ZhuochengHU/UCR/EE175_FILES/Hardware design/Remote-control/remote-control.pdf

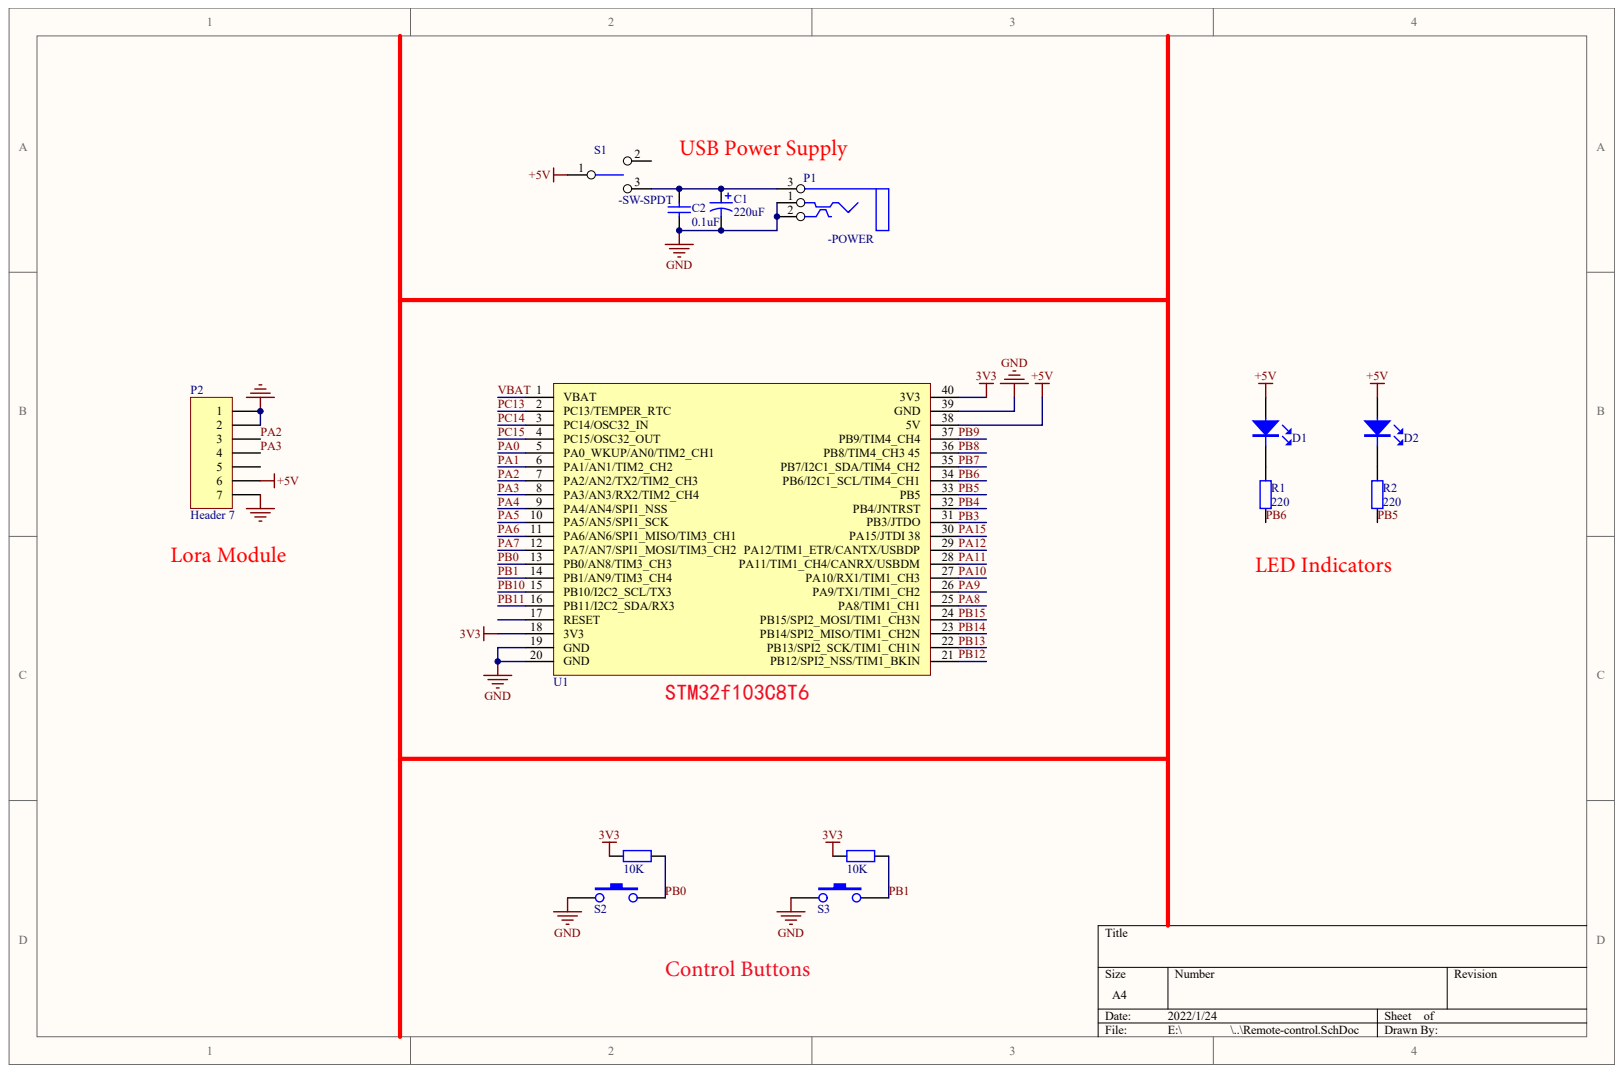
[picture p10: page 1]

GND 19 | PB13
GND 20 | PB12

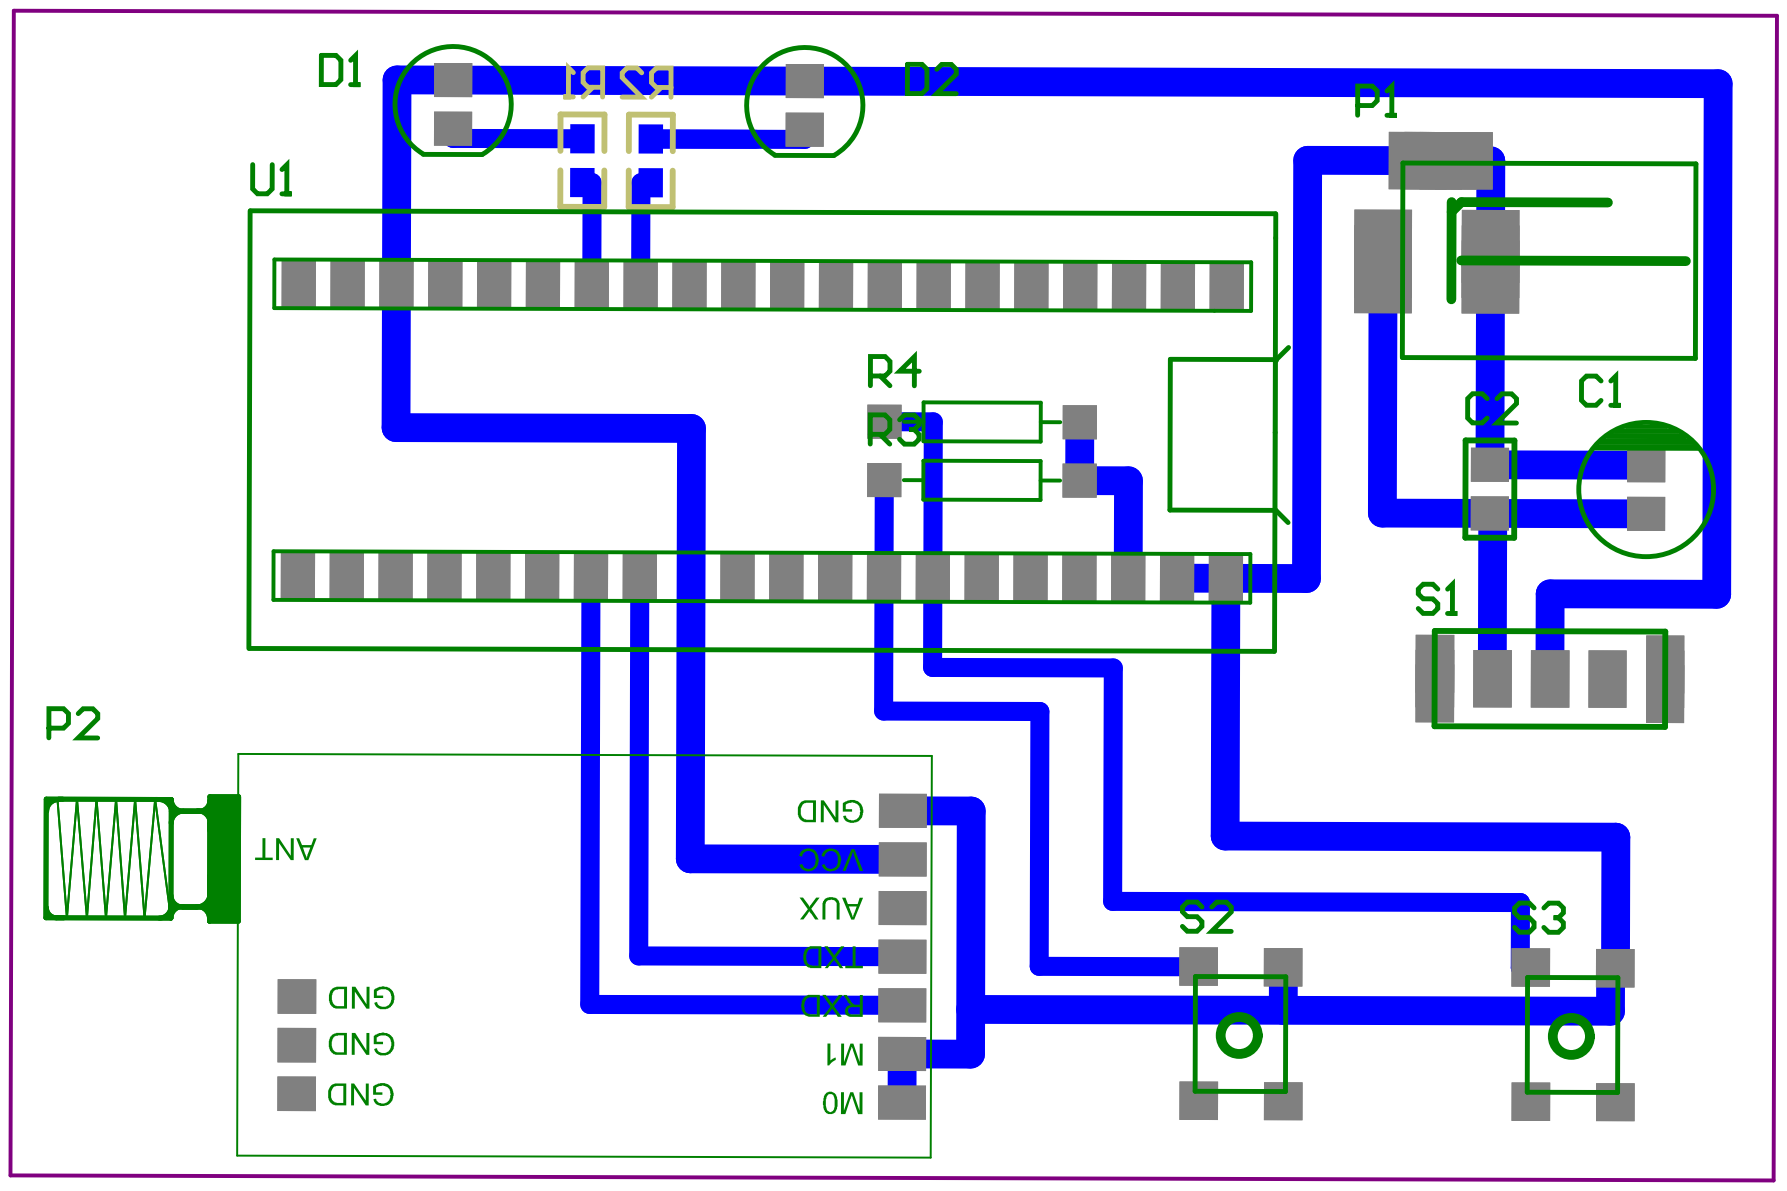
[picture p11: page 2]
