ZhuochengHU/UCR/EE175_FILES/Hardware design/Socket-board/Socket-board.pdf

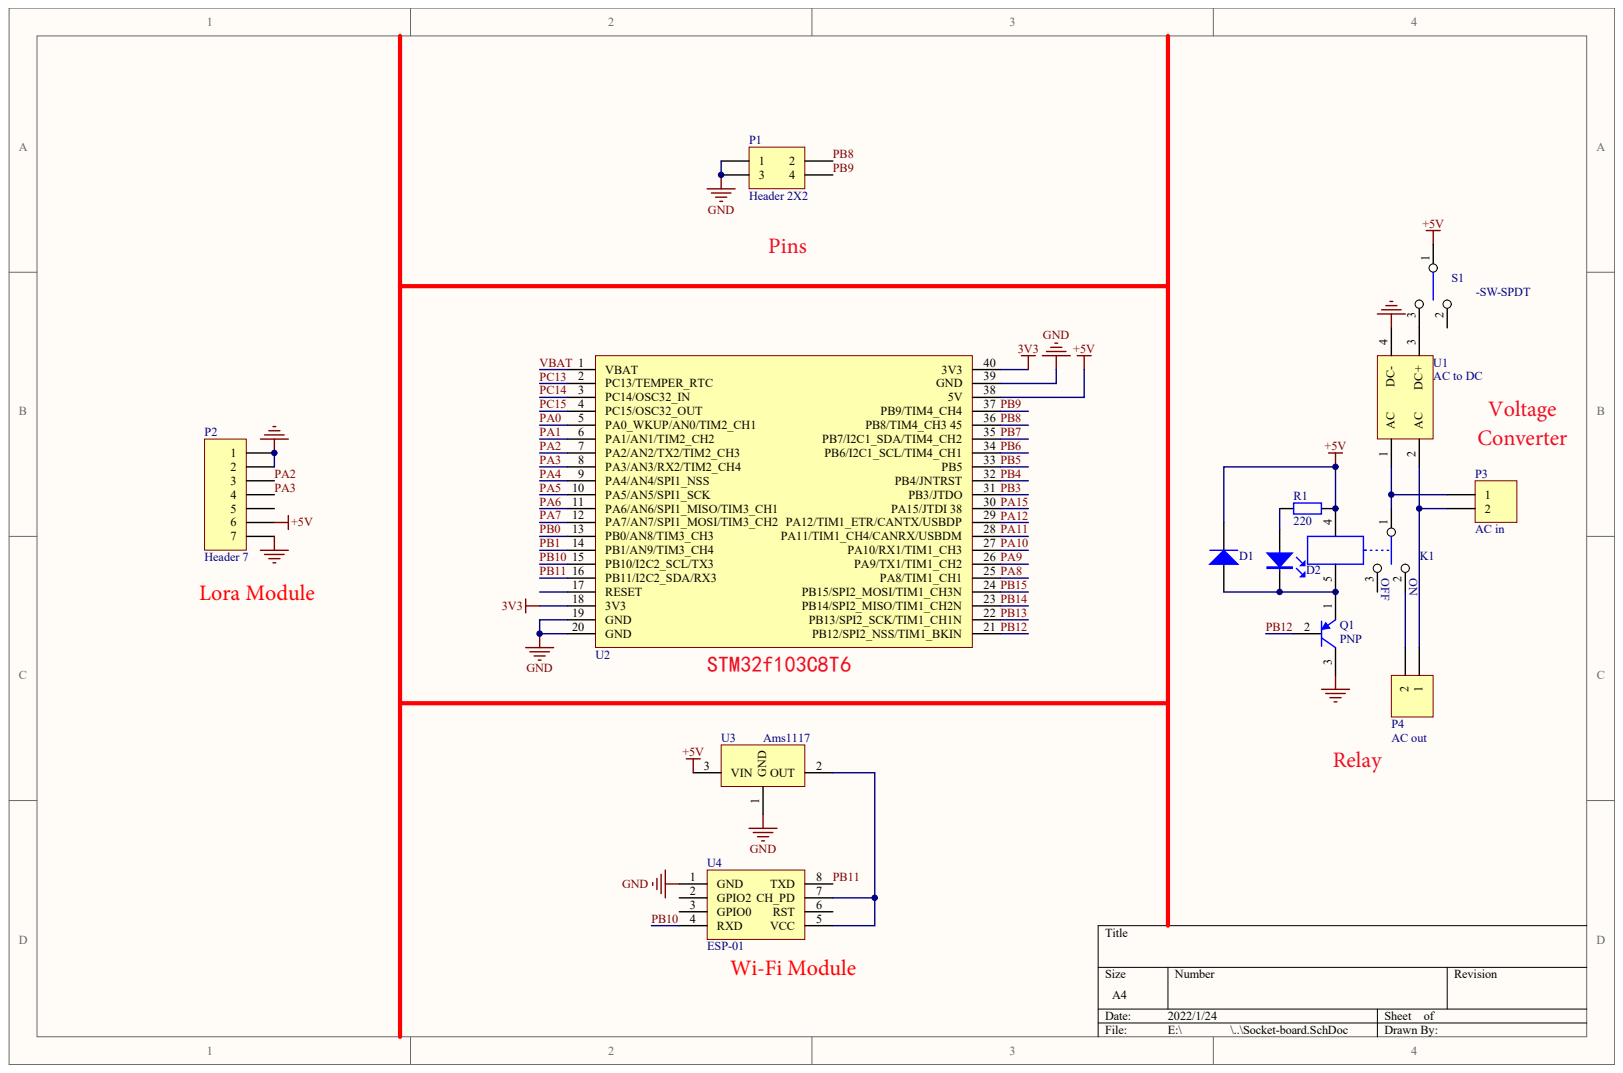
[picture p12: page 1]

GND 19 | PB13
GND 20 | PB12

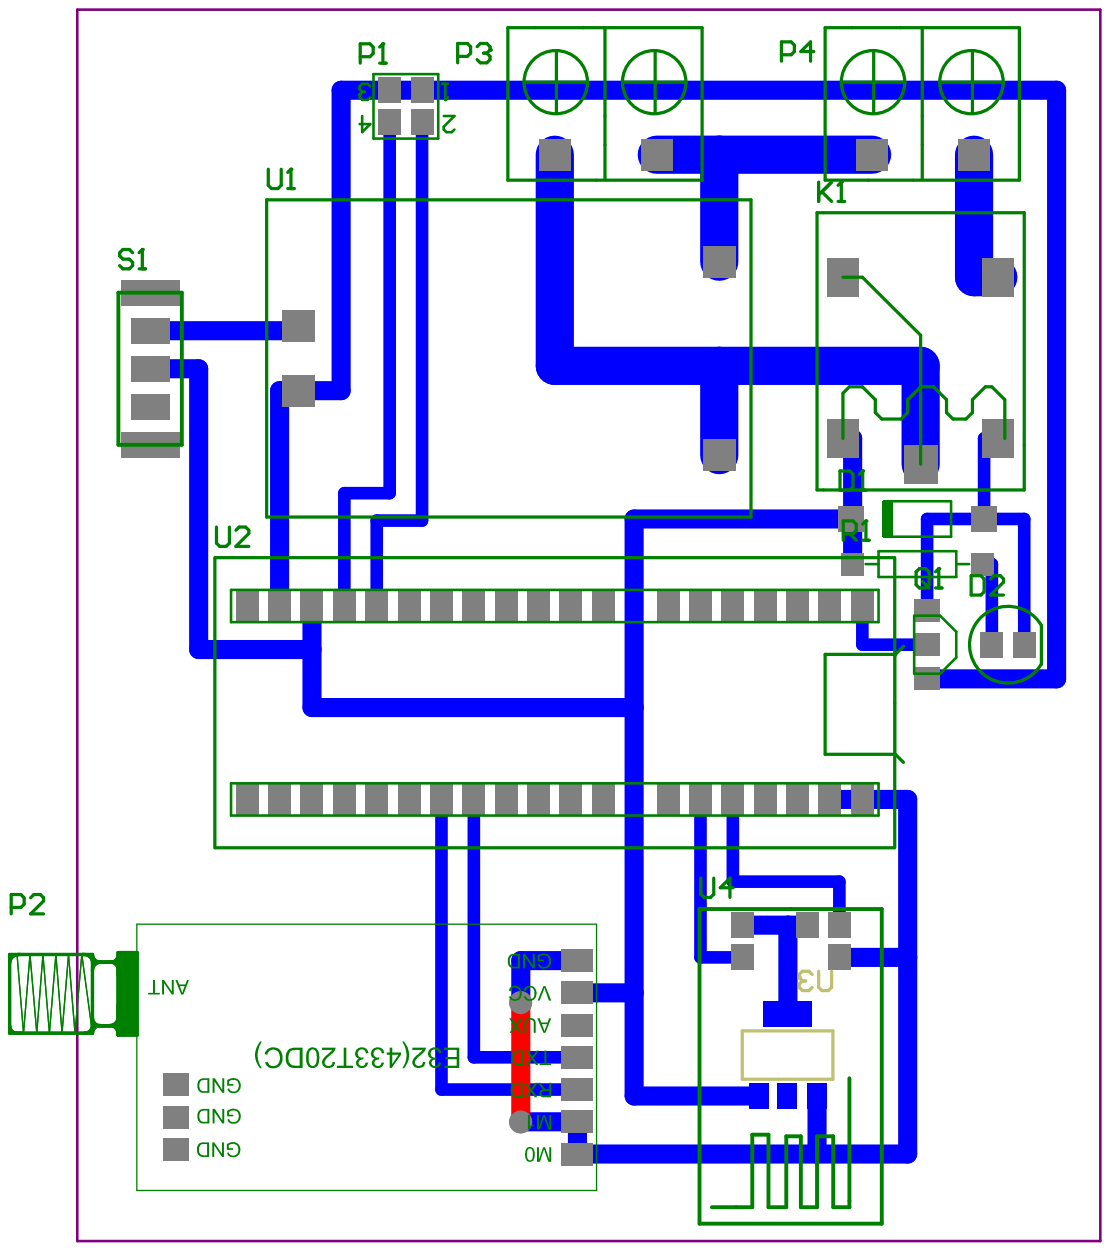
[picture p13: page 2]
