ZhuochengHU/UCR/(list of files, drawings)

Other design files:
EE175_FILES/Hardware design/Remote-control/Remote-control.PcbDoc
EE175_FILES/Hardware design/Remote-control/Remote-control.PrjPcb
EE175_FILES/Hardware design/Remote-control/Remote-control.SchDoc
EE175_FILES/Hardware design/Socket-board/Socket-board.PcbDoc
EE175_FILES/Hardware design/Socket-board/Socket-board.PrjPcb
EE175_FILES/Hardware design/Socket-board/Socket-board.SchDoc
