ZhuochengHU/UCR/EE 120B/Lab 3/turnin/zhu026_lab3_part3.c

/*	Author: zhu026
 *  Partner(s) Name: Jo Smith
 *	Lab Section:
 *	Assignment:
 *	Exercise Description: [optional - include for your own benefit]
 *
 *	I acknowledge all content contained herein, excluding template or example
 *	code, is my own original work.
 */
#include <avr/io.h>
#ifdef _SIMULATE_
#include "simAVRHeader.h"
#endif

int main(void) {
    /* Insert DDR and PORT initializations */
    /* Insert your solution below */
    DDRA = 0x00; PORTA = 0xFF;
    DDRC = 0xFF; PORTC = 0x00;
    unsigned char tempA = 0x00;
    unsigned char tempC = 0x00;

    while (1) {
	tempA = PINA;
	tempC = 0x00;
	if (((tempA & 0x0D) == 0x0D) || ((tempA & 0x0E) == 0x0E) || ((tempA & 0x0F) == 0x0F)) {
                tempC = 0x3F;
        }
	else if (((tempA & 0x0A) == 0x0A) || ((tempA & 0x0B) == 0x0B) || ((tempA & 0x0C) == 0x0C)) {
                tempC = 0x3E;
        }
	else if (((tempA & 0x07) == 0x07) || ((tempA & 0x08) == 0x08) || ((tempA & 0x09) == 0x09)) {
                tempC = 0x3C;
        }
	else if (((tempA & 0x05) == 0x05) || ((tempA & 0x06) == 0x06)) {
                tempC = 0x38;
        }
	else if (((tempA & 0x03) == 0x03) || ((tempA & 0x04) == 0x04)) {
                tempC = 0x70;
        }
	else if (((tempA & 0x01) == 0x01) || ((tempA & 0x02) == 0x02)) {
		tempC = 0x60;
	}
	else {
		tempC = 0x40;
	}
	
	if (((tempA & 0x30) == 0x30) && (tempA & 0x40) != 0x40) {
		tempC = tempC | 0x80;
	}
	
	
	PORTC = tempC;
	
    }
    return 0;
}
