ZhuochengHU/UCR/EE175_FILES/Embedded system/Remote-control/SYSTEM/usart/usart.c

#include "sys.h"
#include "usart.h"	  

unsigned char Uart1_Receive_Data;
unsigned char Uart1_Receive_Change=0;

/*
  功能描述: 发送一个字节
  函数参数: byte —— 要发送的字节
  返回说明: 无
*/
void UART_SendByte(unsigned char byte)	
{
	USART_SendData(USART1,byte);//向串口1发送数据
	while(USART_GetFlagStatus(USART1,USART_FLAG_TC)!=SET);//等待发送结束
}

/*
  功能描述: 串口发送字符串
  函数参数: s —— 指向字符串的指针(字符串以'\0'结尾)
  返回说明: 无
  注：如果在字符串结尾有'\n'，则会发送一个回车换行      
*/
void UART_SendStr(unsigned char *s)
{
	while( *s != '\0')
	{
		UART_SendByte( *s );	
		s ++;
	}
}
 
void uart_init(u32 bound)
{
    //GPIO端口设置
    GPIO_InitTypeDef GPIO_InitStructure;
	USART_InitTypeDef USART_InitStructure;
	NVIC_InitTypeDef NVIC_InitStructure;
	 
	RCC_APB2PeriphClockCmd(RCC_APB2Periph_USART1|RCC_APB2Periph_GPIOA, ENABLE);	//使能USART1，GPIOA时钟
     //USART1_TX   PA.9
    GPIO_InitStructure.GPIO_Pin = GPIO_Pin_9; //PA.9
    GPIO_InitStructure.GPIO_Speed = GPIO_Speed_50MHz;
    GPIO_InitStructure.GPIO_Mode = GPIO_Mode_AF_PP;	//复用推挽输出
    GPIO_Init(GPIOA, &GPIO_InitStructure);
   
    //USART1_RX	  PA.10
    GPIO_InitStructure.GPIO_Pin = GPIO_Pin_10;
    GPIO_InitStructure.GPIO_Mode = GPIO_Mode_IPU;//上拉输入
    GPIO_Init(GPIOA, &GPIO_InitStructure);  

   //Usart1 NVIC 配置

    NVIC_InitStructure.NVIC_IRQChannel = USART1_IRQn;
	NVIC_InitStructure.NVIC_IRQChannelPreemptionPriority=3 ;//抢占优先级3
	NVIC_InitStructure.NVIC_IRQChannelSubPriority = 3;		//子优先级3
	NVIC_InitStructure.NVIC_IRQChannelCmd = ENABLE;			//IRQ通道使能
	NVIC_Init(&NVIC_InitStructure);	//根据指定的参数初始化VIC寄存器
  
   //USART 初始化设置

	USART_InitStructure.USART_BaudRate = bound;//一般设置为9600;
	USART_InitStructure.USART_WordLength = USART_WordLength_8b;//字长为8位数据格式
	USART_InitStructure.USART_StopBits = USART_StopBits_1;//一个停止位
	USART_InitStructure.USART_Parity = USART_Parity_No;//无奇偶校验位
	USART_InitStructure.USART_HardwareFlowControl = USART_HardwareFlowControl_None;//无硬件数据流控制
	USART_InitStructure.USART_Mode = USART_Mode_Rx | USART_Mode_Tx;	//收发模式

    USART_Init(USART1, &USART_InitStructure); //初始化串口
    USART_ITConfig(USART1, USART_IT_RXNE, ENABLE);//开启中断
    USART_Cmd(USART1, ENABLE);                    //使能串口 
		UART_SendByte(0xff);

}


void USART1_IRQHandler(void)                	//串口1中断服务程序
{
	u8 Res;
	if(USART_GetITStatus(USART1, USART_IT_RXNE) != RESET)  //接收中断
	{
		Res =USART_ReceiveData(USART1);//(USART1->DR);	//读取接收到的数据		 
		Uart1_Receive_Data=Res;
		Uart1_Receive_Change=1;
	} 
} 	
