ZhuochengHU/UCR/EE175_FILES/Embedded system/Remote-control/MyCode/UART2.c

#include "UART2.h"

unsigned char Uart2_Receive_Data;
unsigned char Uart2_Receive_Change=0;




/*
  功能描述: 发送一个字节
  函数参数: byte —— 要发送的字节
  返回说明: 无
*/
void UART2_SendByte(unsigned char byte)	
{
	USART_SendData(USART2,byte);//向串口1发送数据
	while(USART_GetFlagStatus(USART2,USART_FLAG_TC)!=SET);//等待发送结束
}

/*
  功能描述: 串口发送字符串
  函数参数: s —— 指向字符串的指针(字符串以'\0'结尾)
  返回说明: 无
  注：如果在字符串结尾有'\n'，则会发送一个回车换行      
*/
void UART2_SendStr(unsigned char *s)
{
	while( *s != '\0')
	{
		UART2_SendByte( *s );	
		s ++;
	}
}

//初始化IO 串口2
//pclk1:PCLK1时钟频率(Mhz)
//bound:波特率	  
void Uart2_Init(u32 bound)
{  
  GPIO_InitTypeDef GPIO_InitStructure;
  USART_InitTypeDef USART_InitStructure;
 	NVIC_InitTypeDef NVIC_InitStructure;
 
	RCC_APB2PeriphClockCmd(RCC_APB2Periph_GPIOA, ENABLE);//使能GPIOA时钟
	RCC_APB1PeriphClockCmd(RCC_APB1Periph_USART2,ENABLE);//使能USART2时钟
	

	GPIO_InitStructure.GPIO_Pin = GPIO_Pin_2;	//PA2
	GPIO_InitStructure.GPIO_Speed = GPIO_Speed_50MHz;
  GPIO_InitStructure.GPIO_Mode = GPIO_Mode_AF_PP;	//复用推挽
  GPIO_Init(GPIOA, &GPIO_InitStructure);
   
  GPIO_InitStructure.GPIO_Pin = GPIO_Pin_3;//PA3
  GPIO_InitStructure.GPIO_Mode = GPIO_Mode_IPU;//上拉输入
  GPIO_Init(GPIOA, &GPIO_InitStructure);  

	RCC_APB1PeriphResetCmd(RCC_APB1Periph_USART2,ENABLE);//复位串口2
	RCC_APB1PeriphResetCmd(RCC_APB1Periph_USART2,DISABLE);//停止复位
 
	
	USART_InitStructure.USART_BaudRate = bound;//一般设置为9600;
	USART_InitStructure.USART_WordLength = USART_WordLength_8b;//8位数据长度
	USART_InitStructure.USART_StopBits = USART_StopBits_1;//一个停止位
	USART_InitStructure.USART_Parity = USART_Parity_No;///奇偶校验位
	USART_InitStructure.USART_HardwareFlowControl = USART_HardwareFlowControl_None;//无硬件数据流控制
	USART_InitStructure.USART_Mode = USART_Mode_Rx|USART_Mode_Tx;//收发模式

  USART_Init(USART2, &USART_InitStructure);  //初始化串口
  
	NVIC_InitStructure.NVIC_IRQChannel = USART2_IRQn; //使能串口2中断
	NVIC_InitStructure.NVIC_IRQChannelPreemptionPriority = 3; //先占优先级2级
	NVIC_InitStructure.NVIC_IRQChannelSubPriority = 3; //从优先级2级
	NVIC_InitStructure.NVIC_IRQChannelCmd = ENABLE; //使能外部中断通道
	NVIC_Init(&NVIC_InitStructure); //根据NVIC_InitStruct中指定的参数初始化外设NVIC寄存器
 
  USART_ITConfig(USART2, USART_IT_RXNE, ENABLE);//开启中断
   
  USART_Cmd(USART2, ENABLE);                    //使能串口  
	UART2_SendByte(0xff);
}
