ZhuochengHU/UCR/EE 120B/lab 4/turnin/zhu026_lab4_part1_tests.py

echo ======================================================\n
echo Running all tests..."\n\n

test "Test no button press"
set state = OffRelease
setPINA 0x00
continue 5
expect state OffRelease
checkResult
